ltyridium/Bidir_AC_DC/1.Hardware/主板原理图.pdf

## Reviewed

## Drawed

## VER

## Create Date Part Number

PAGE | OF

## Schematic

## Update Date

## SIZE

## Page

## ltyridium ltyridium

V0.1 | A3

# Three_phase_power_system

2023-03-13
2023-03-08

# Schematic4

## Topology

控制地

5V 控制

# 辅助电源 12V 1A

# 24v 半桥卡

# 5v 控制卡

# CL+继电器 EMI滤波板

电压采样

电流采样

3.3v 驱动缓冲 | 信号调理

# 黄A 绿B 红C 蓝N

# 白 BUS + 黑 BUS -

# 控制地

# BUS+

# MID

# BUS-

# 500V/2.5mm

# 200V/1mm

# 500V/2.5mm

# 安全隔离等级 200v/mm 电气间隙

2.5mm

2.5mm

# 1000v/5mm

信号线0.15mm
电源线0.5mm

# 3V3_AAGND

U12 1

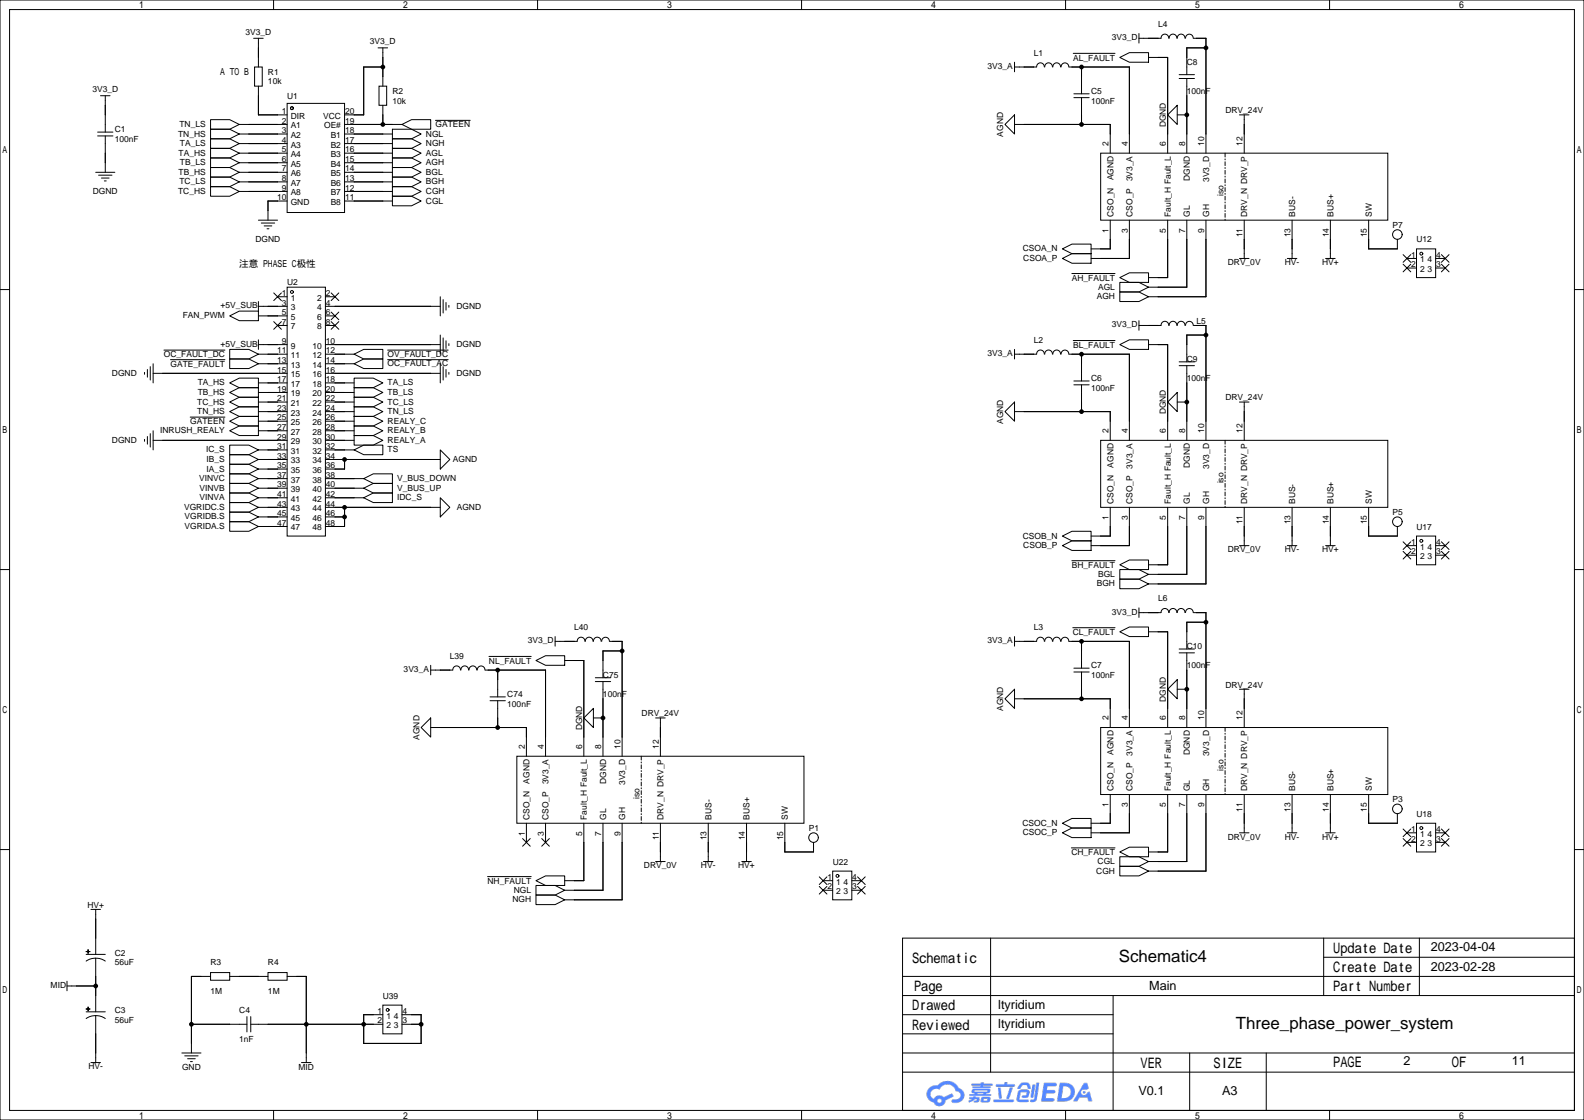
[picture p36: page 2]

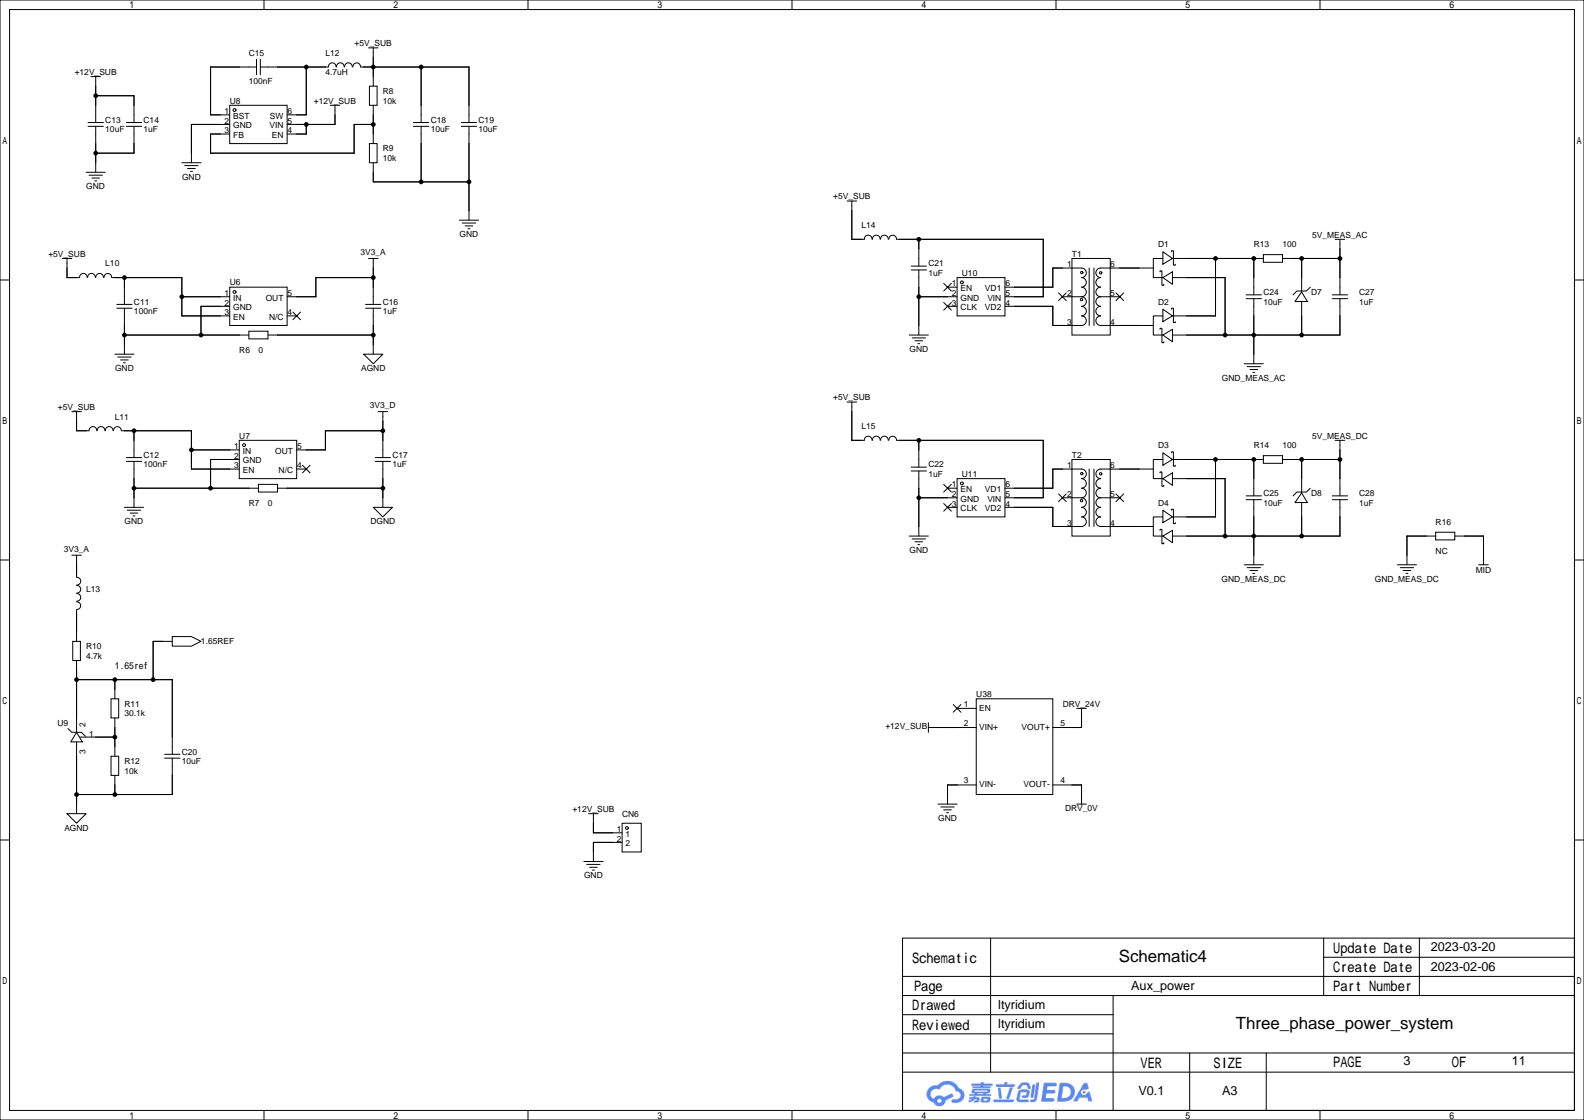
[picture p37: page 3]

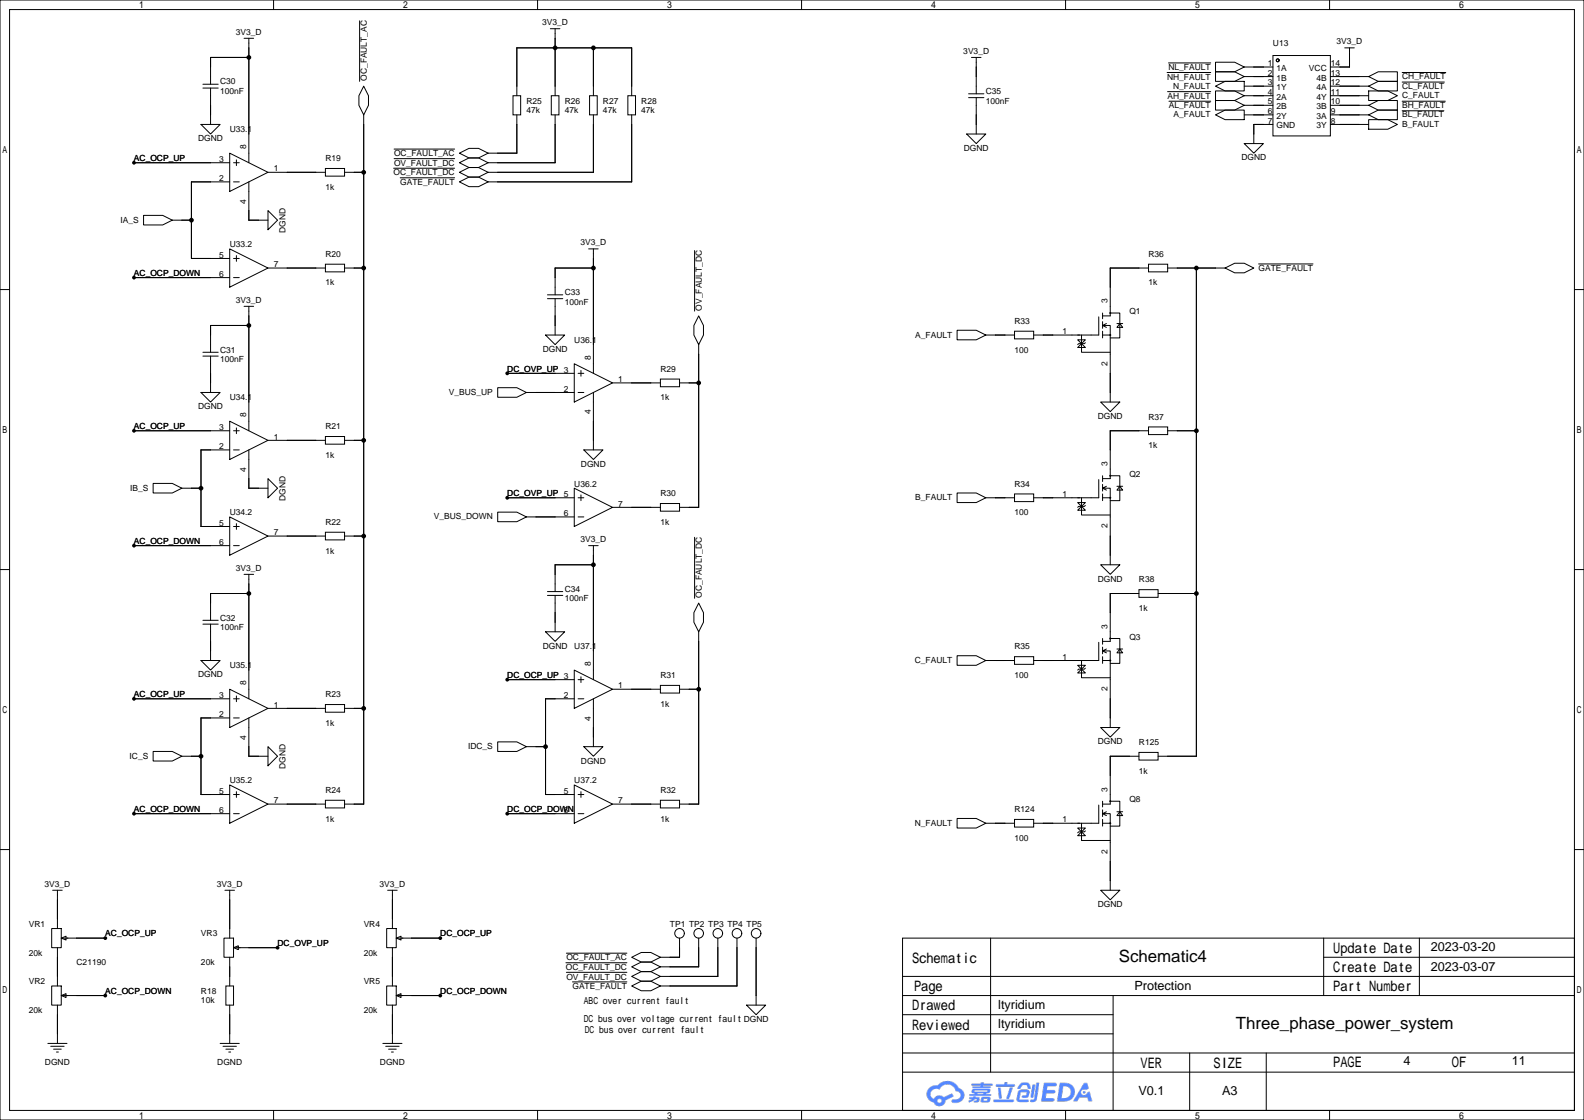
[picture p38: page 4]

DC bus over voltage current fault
DC bus over current fault

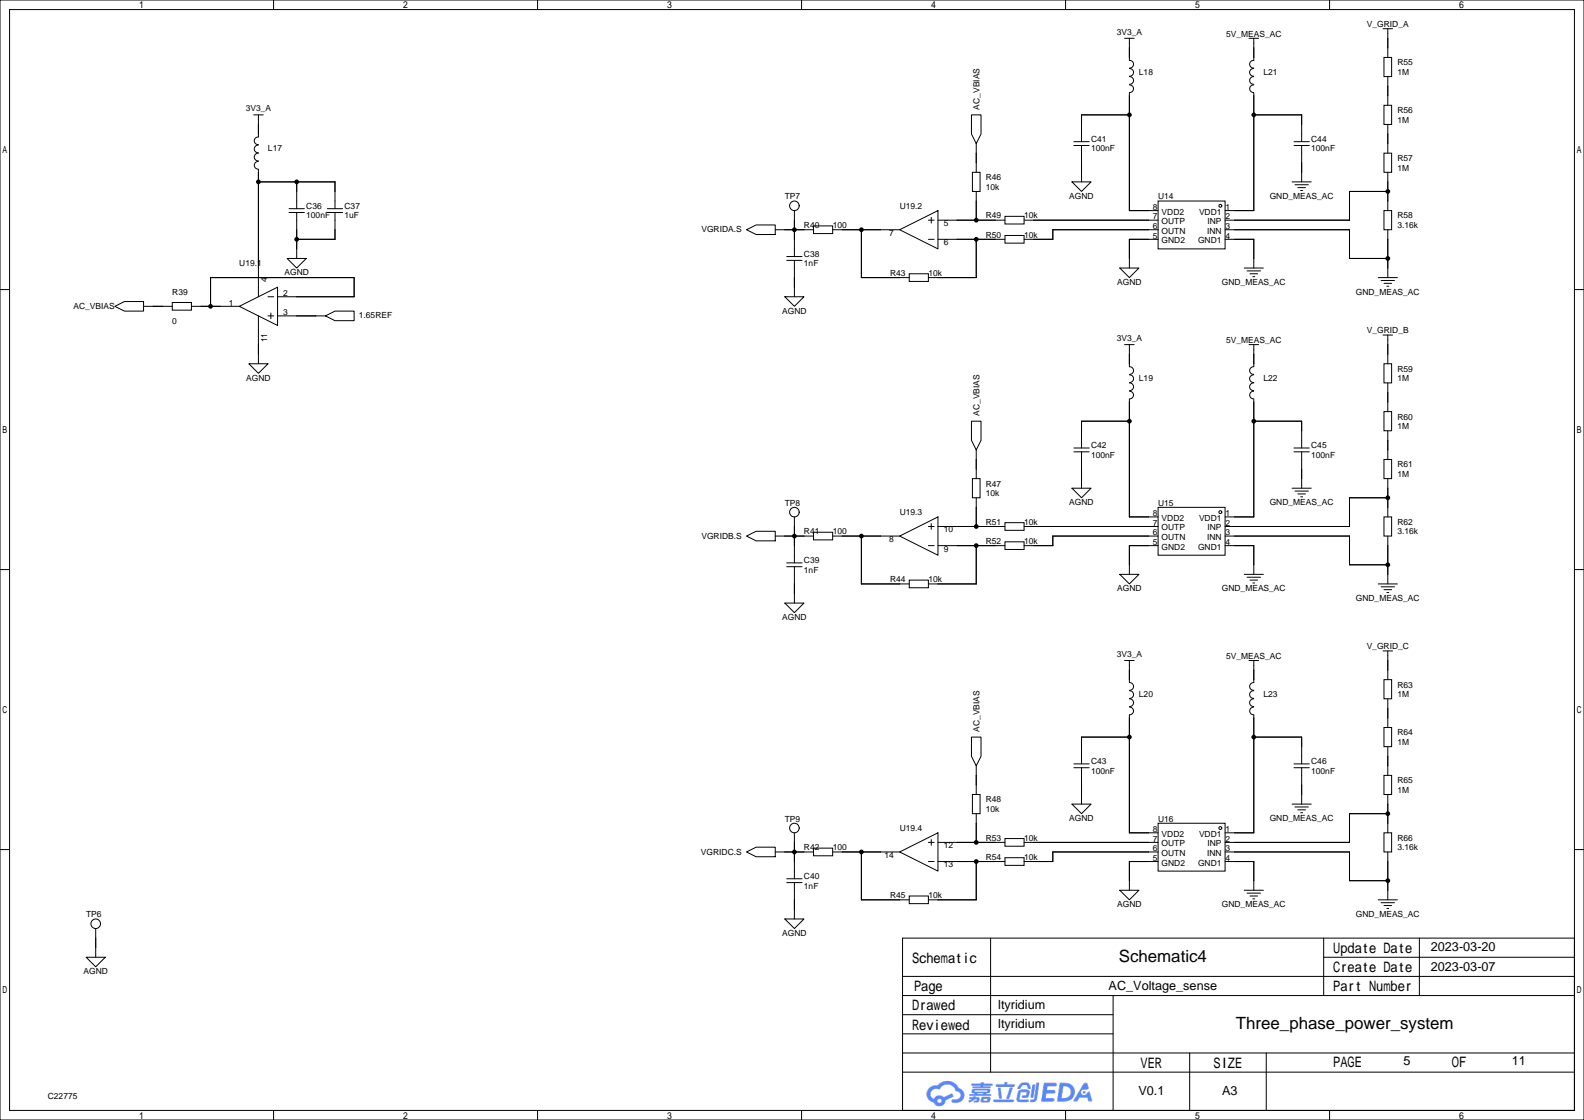
[picture p39: page 5]

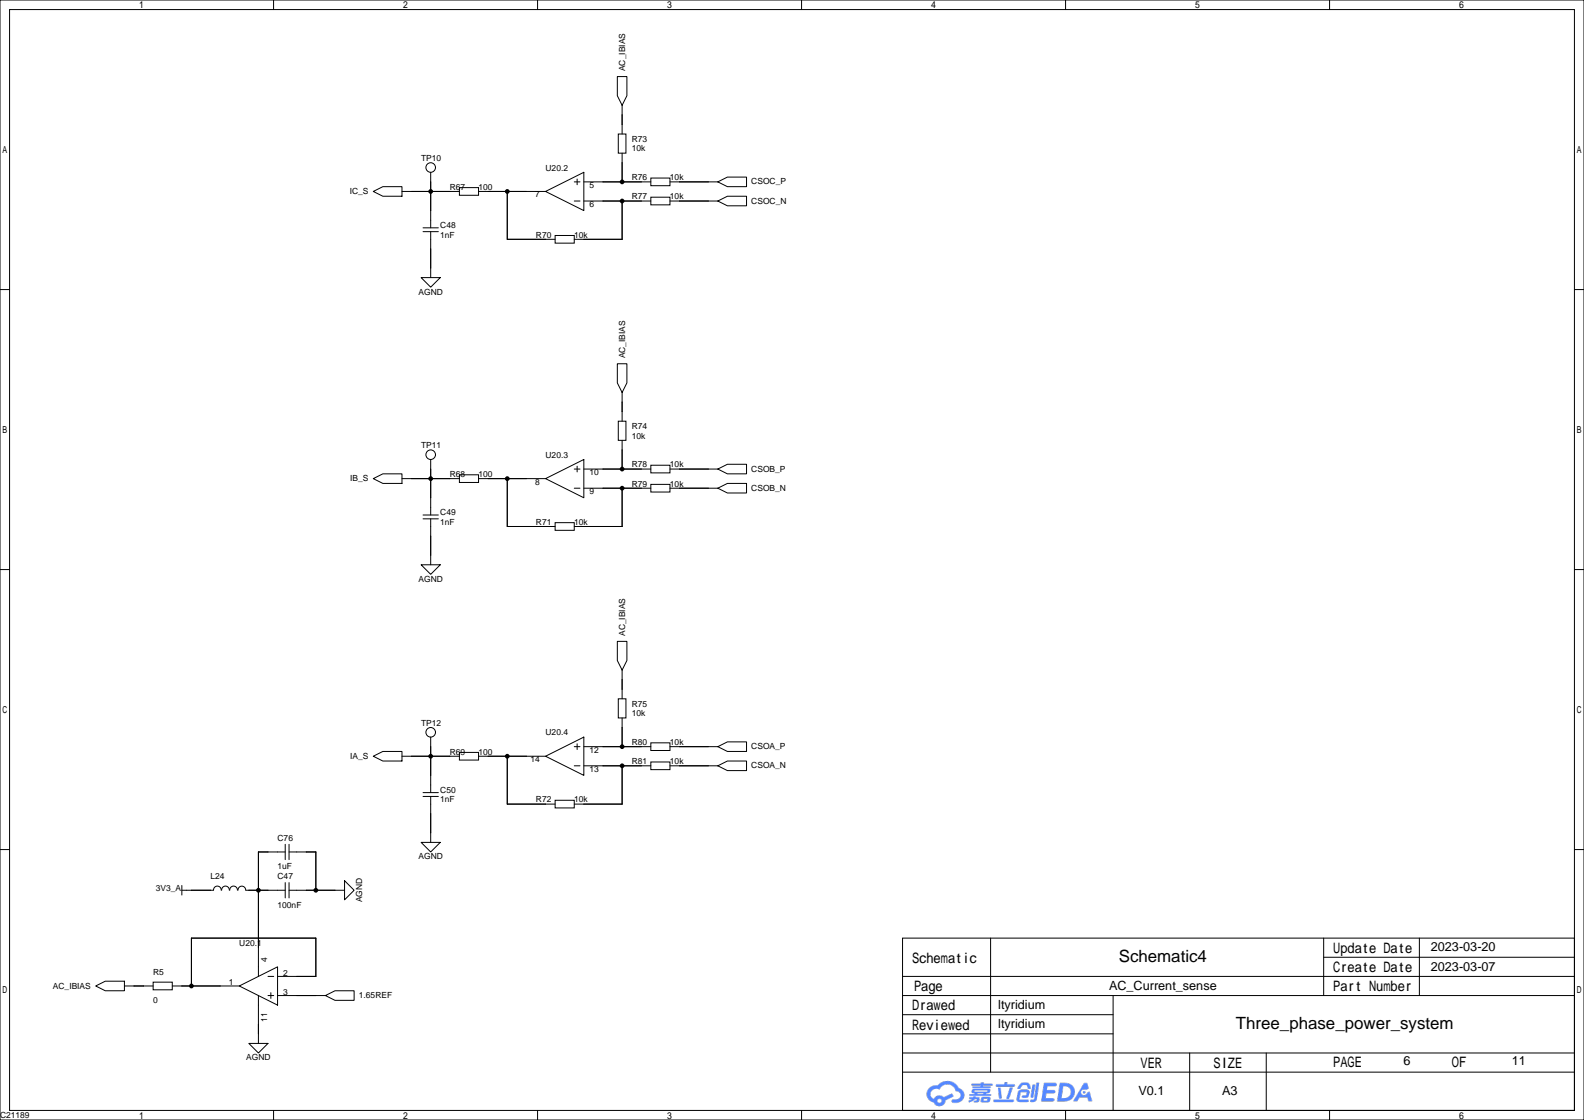
[picture p40: page 6]

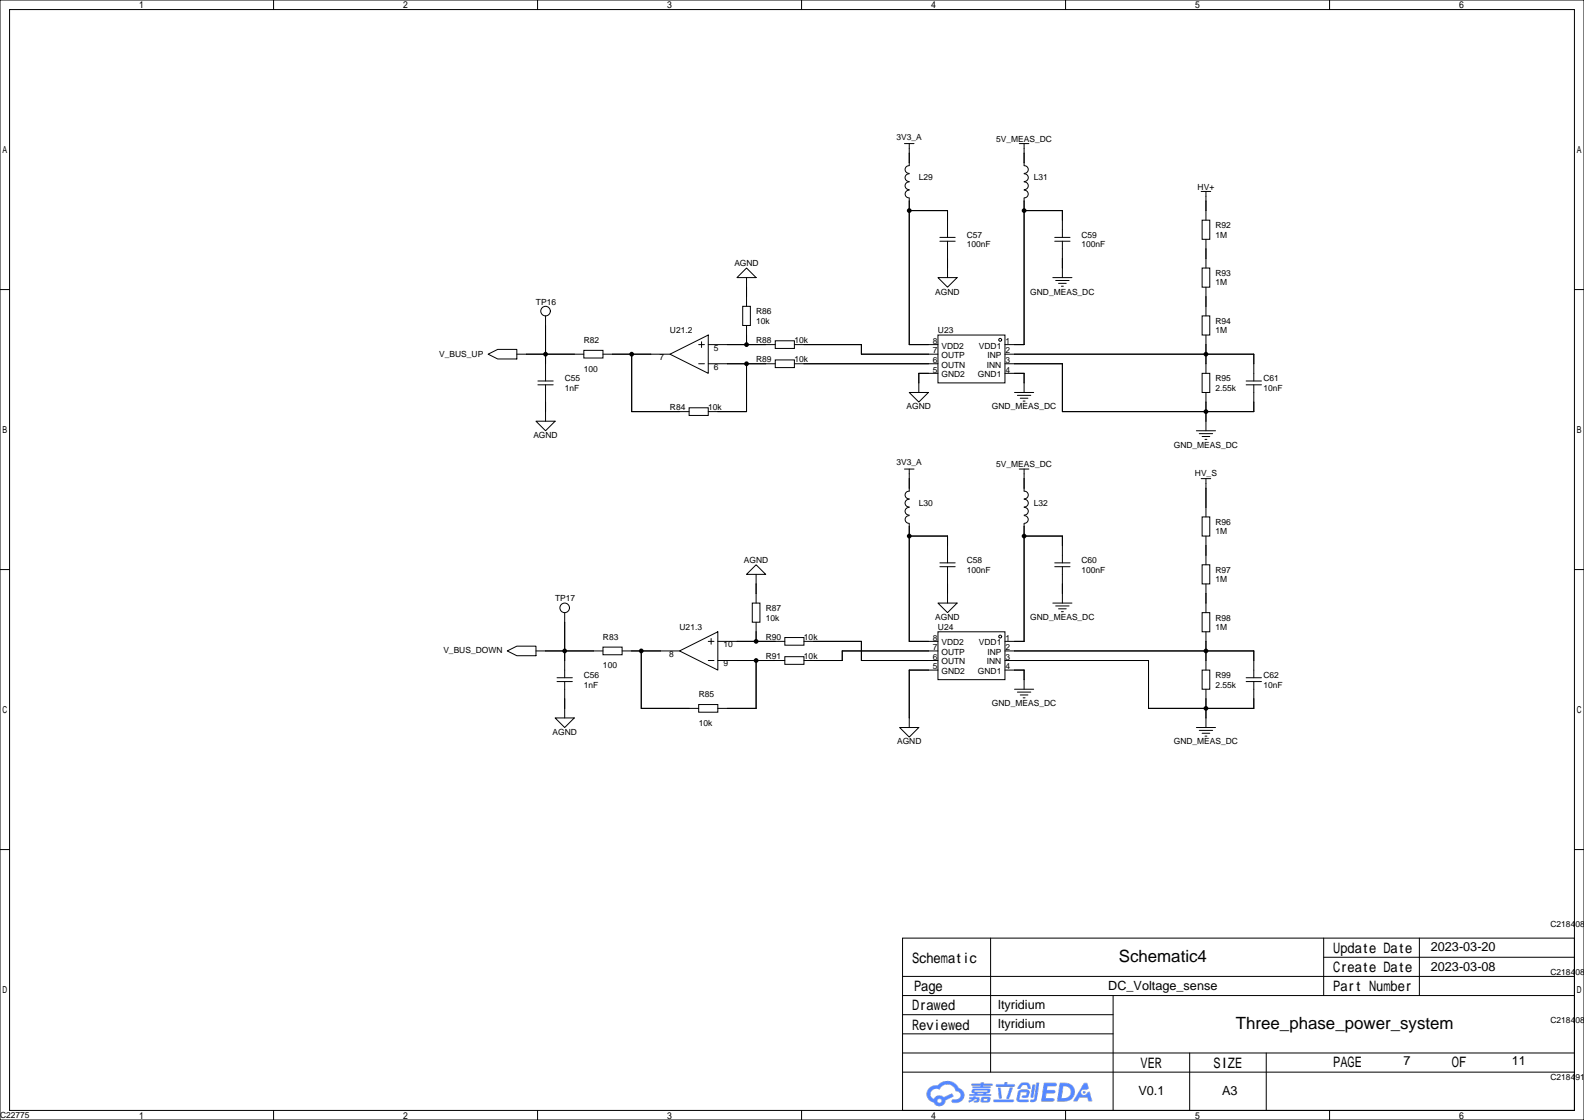
[picture p41: page 7]

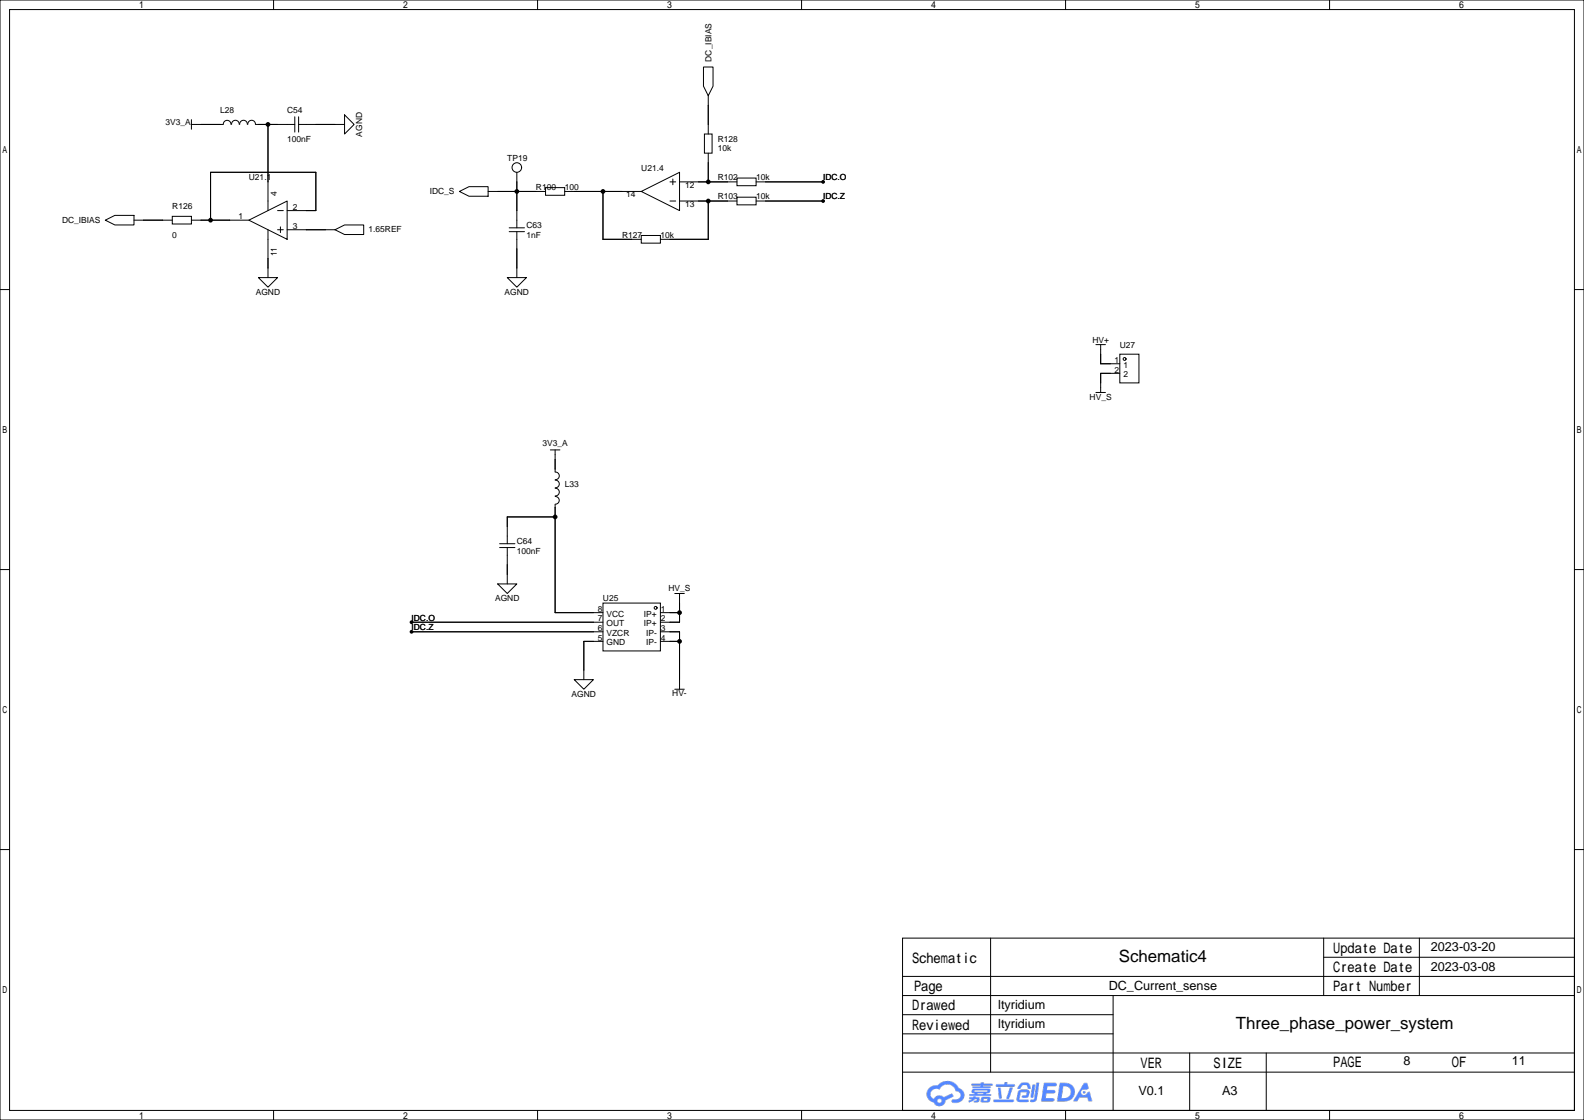
[picture p42: page 8]

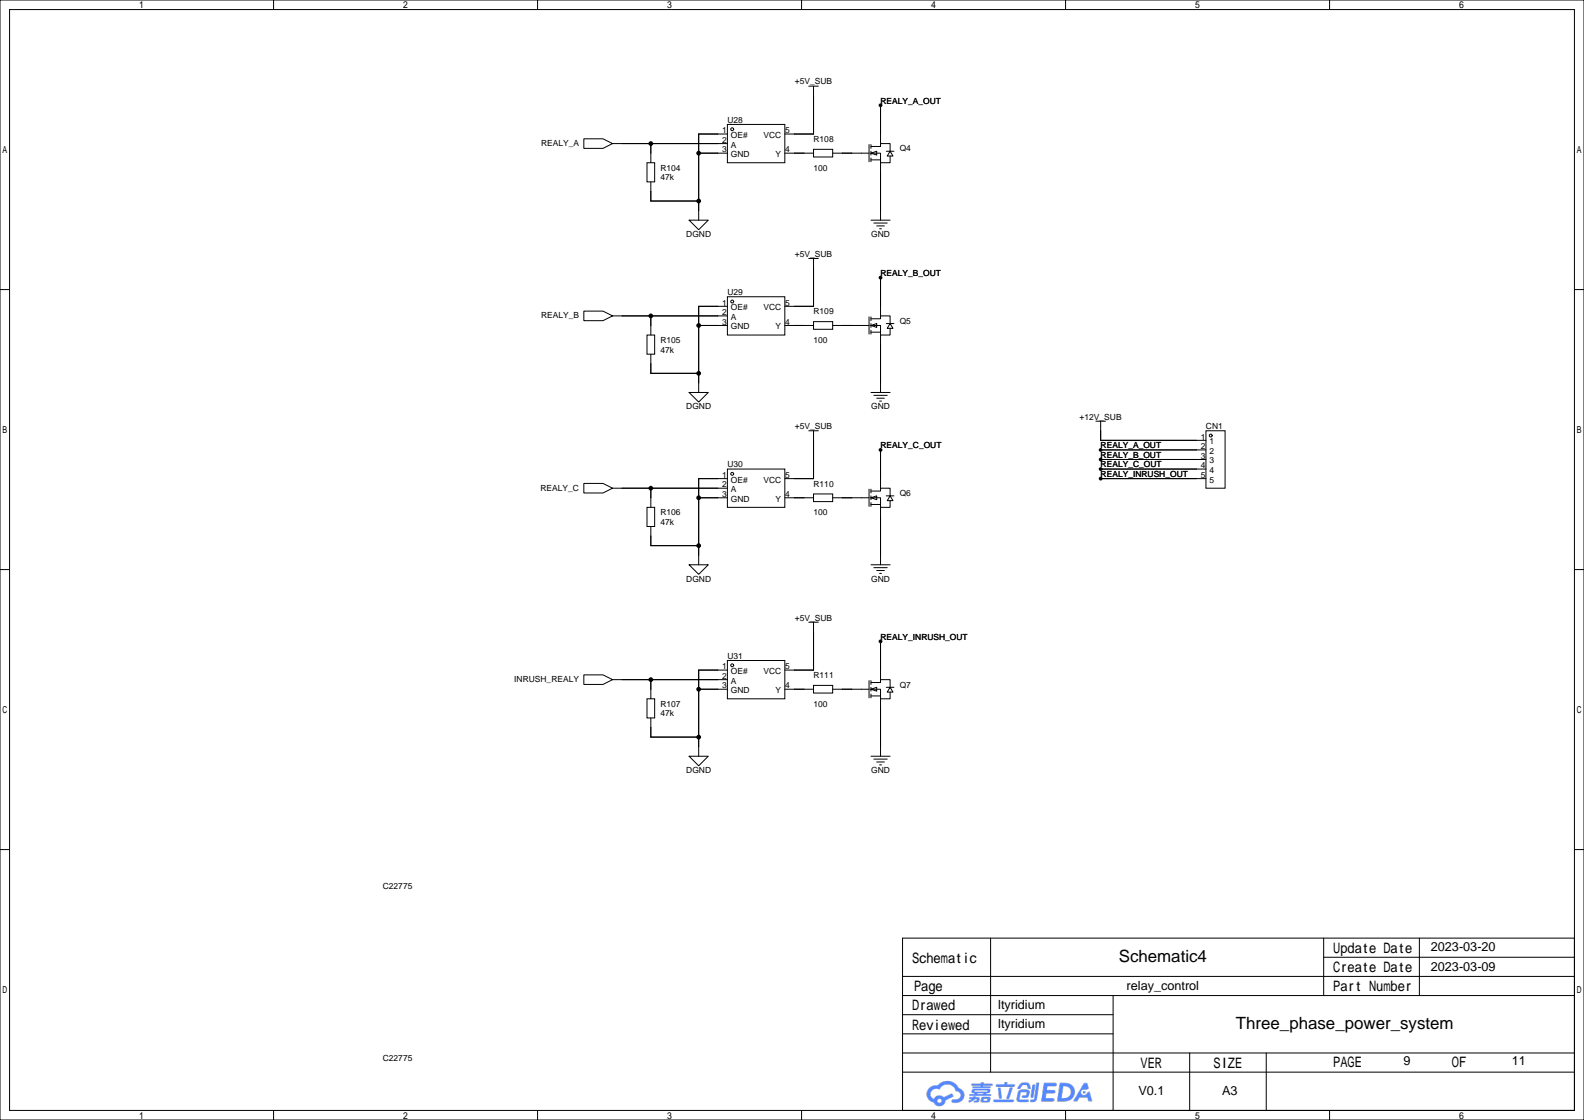
[picture p43: page 9]

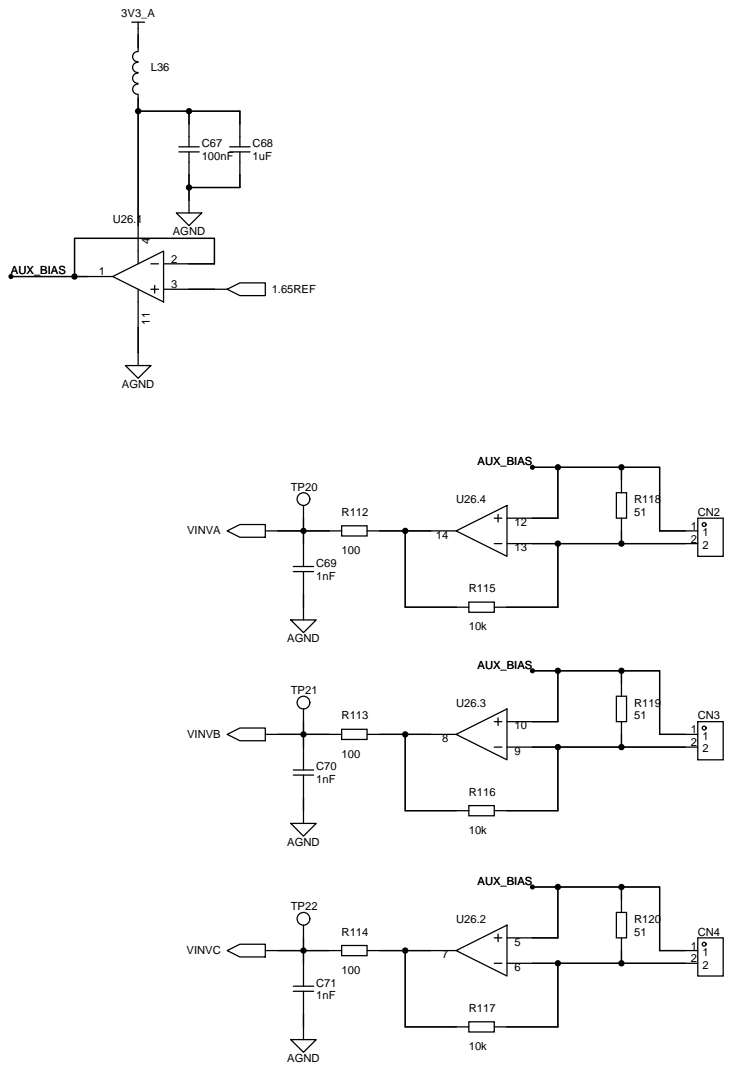
[picture p44: page 10]

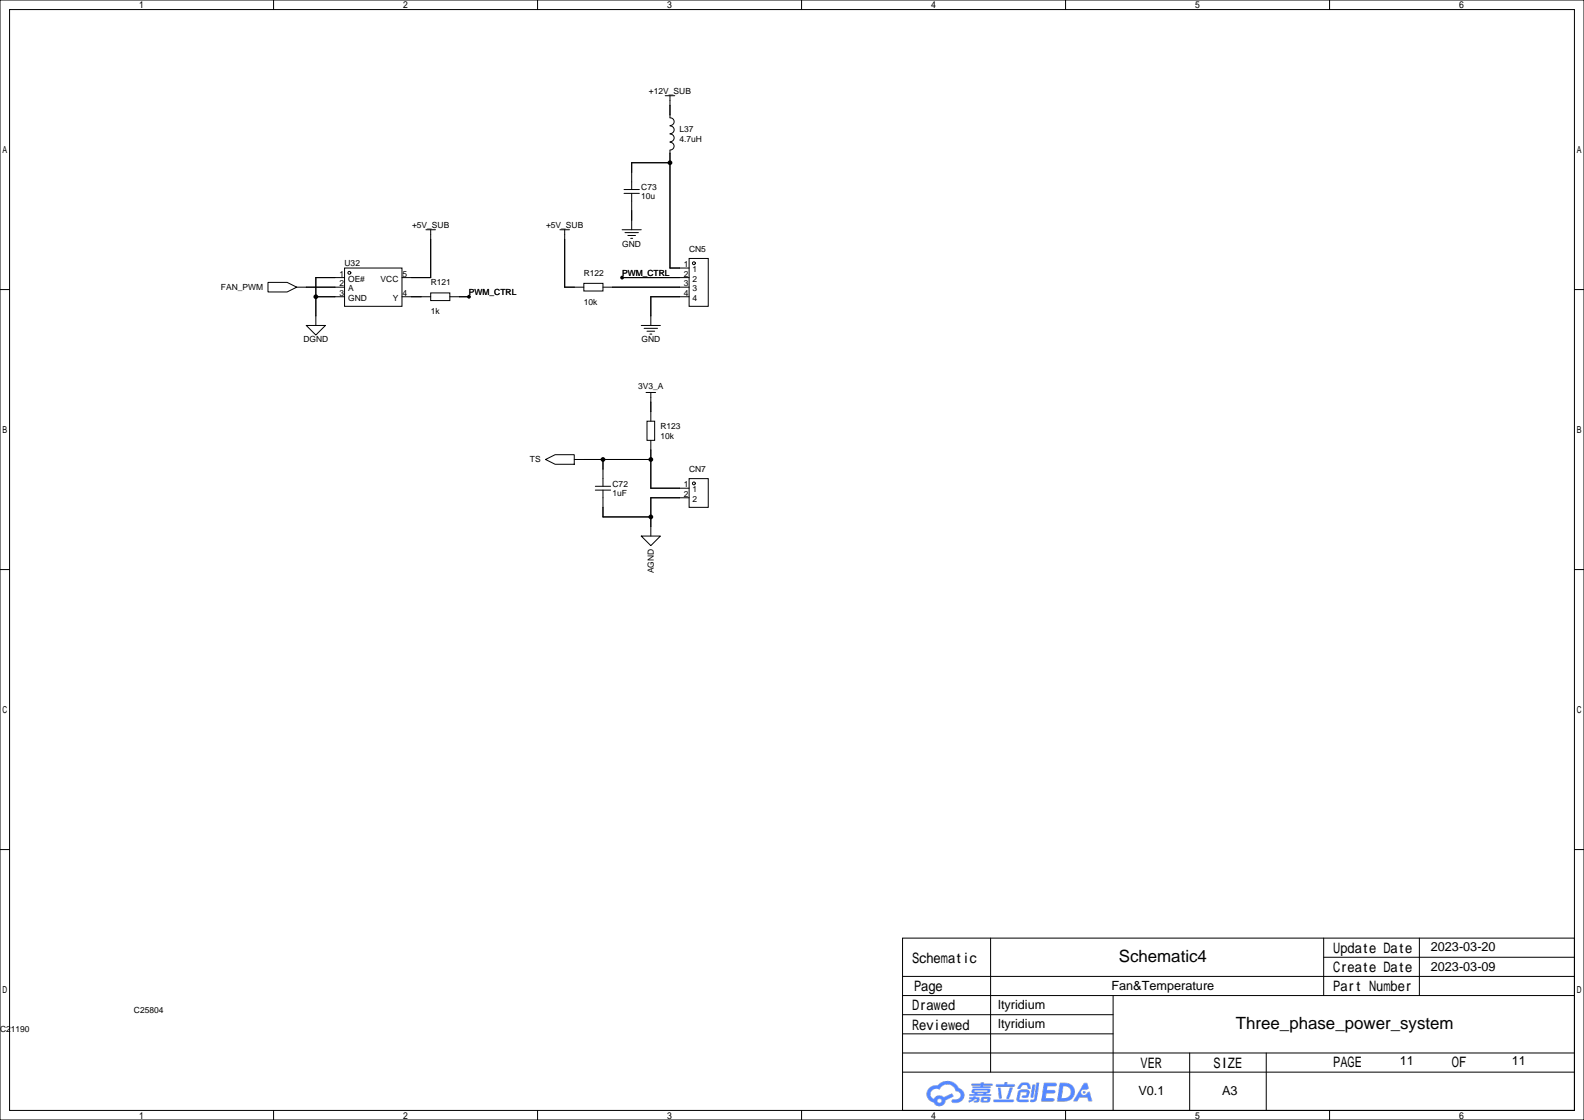
[picture p45: page 11]
