ltyridium/Bidir_AC_DC/1.Hardware/控制卡.pdf

# DGNDI2C¹_SCL I2C¹_SDA

# VDD_3V3 I2C¹_SCL

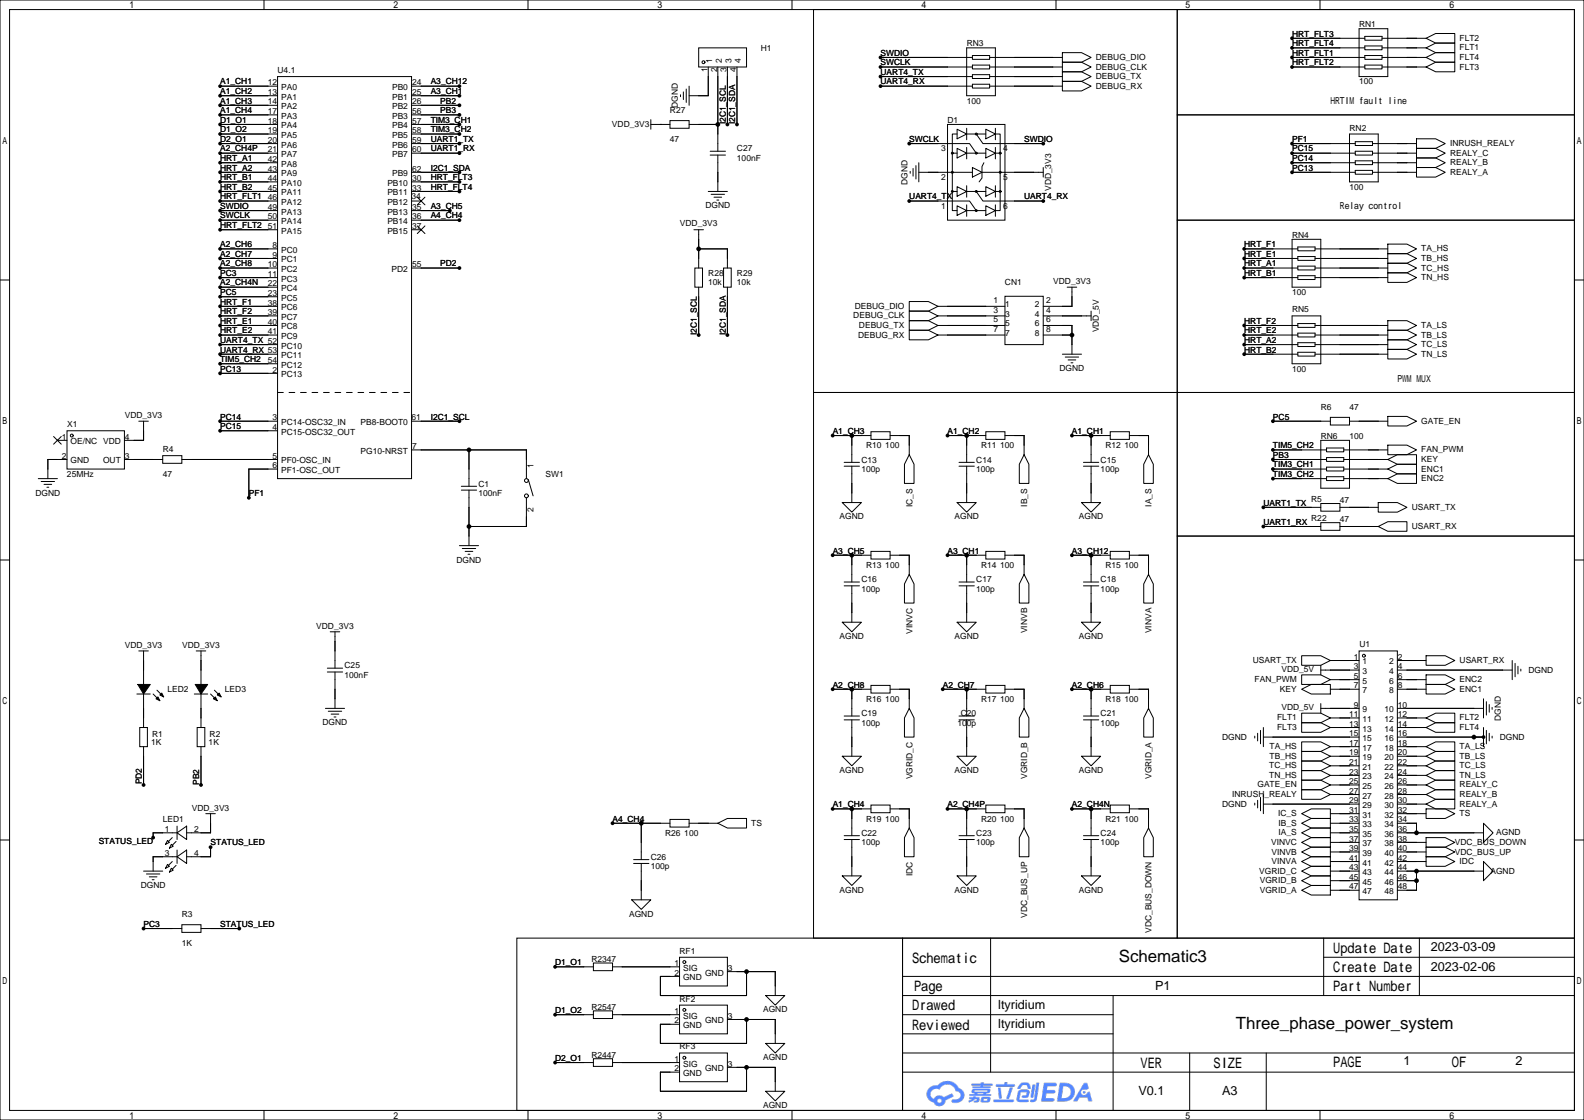
[picture p46: page 1]

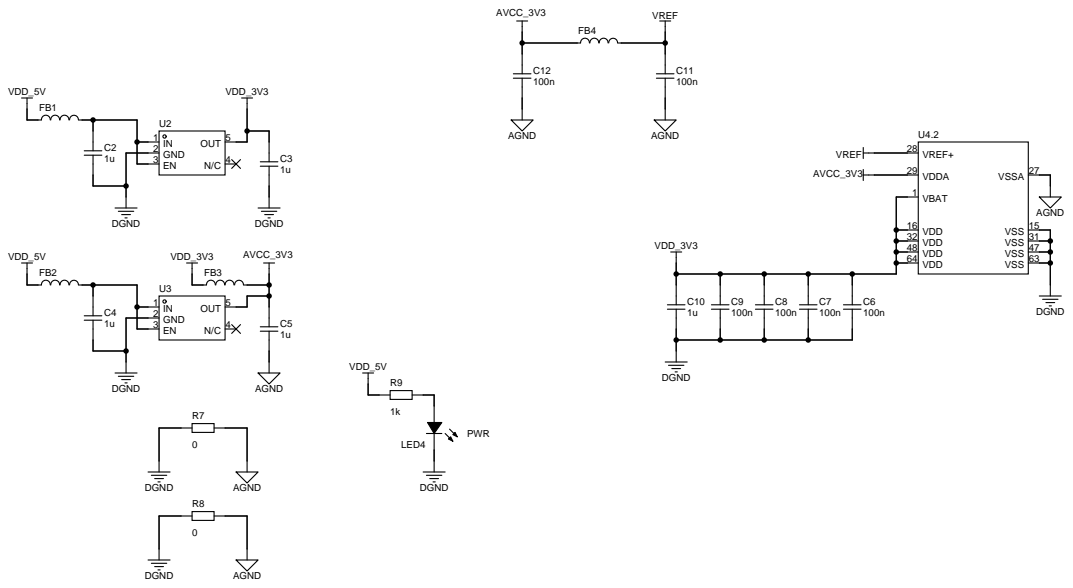
[picture p47: page 2]
