ltyridium/Bidir_AC_DC/1.Hardware/EMI滤波.pdf

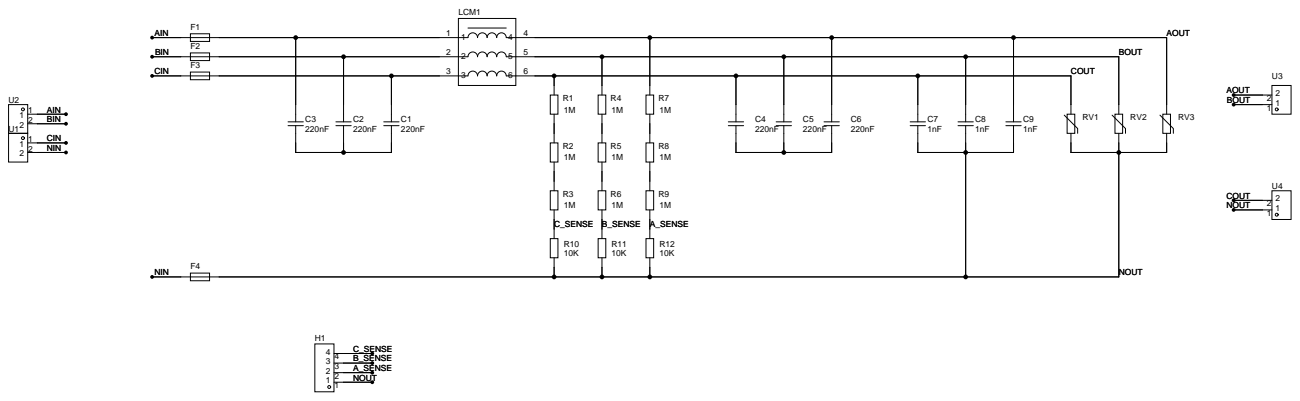
[picture p48: page 1]
