ltyridium/Bidir_AC_DC/1.Hardware/LCL滤波板.pdf

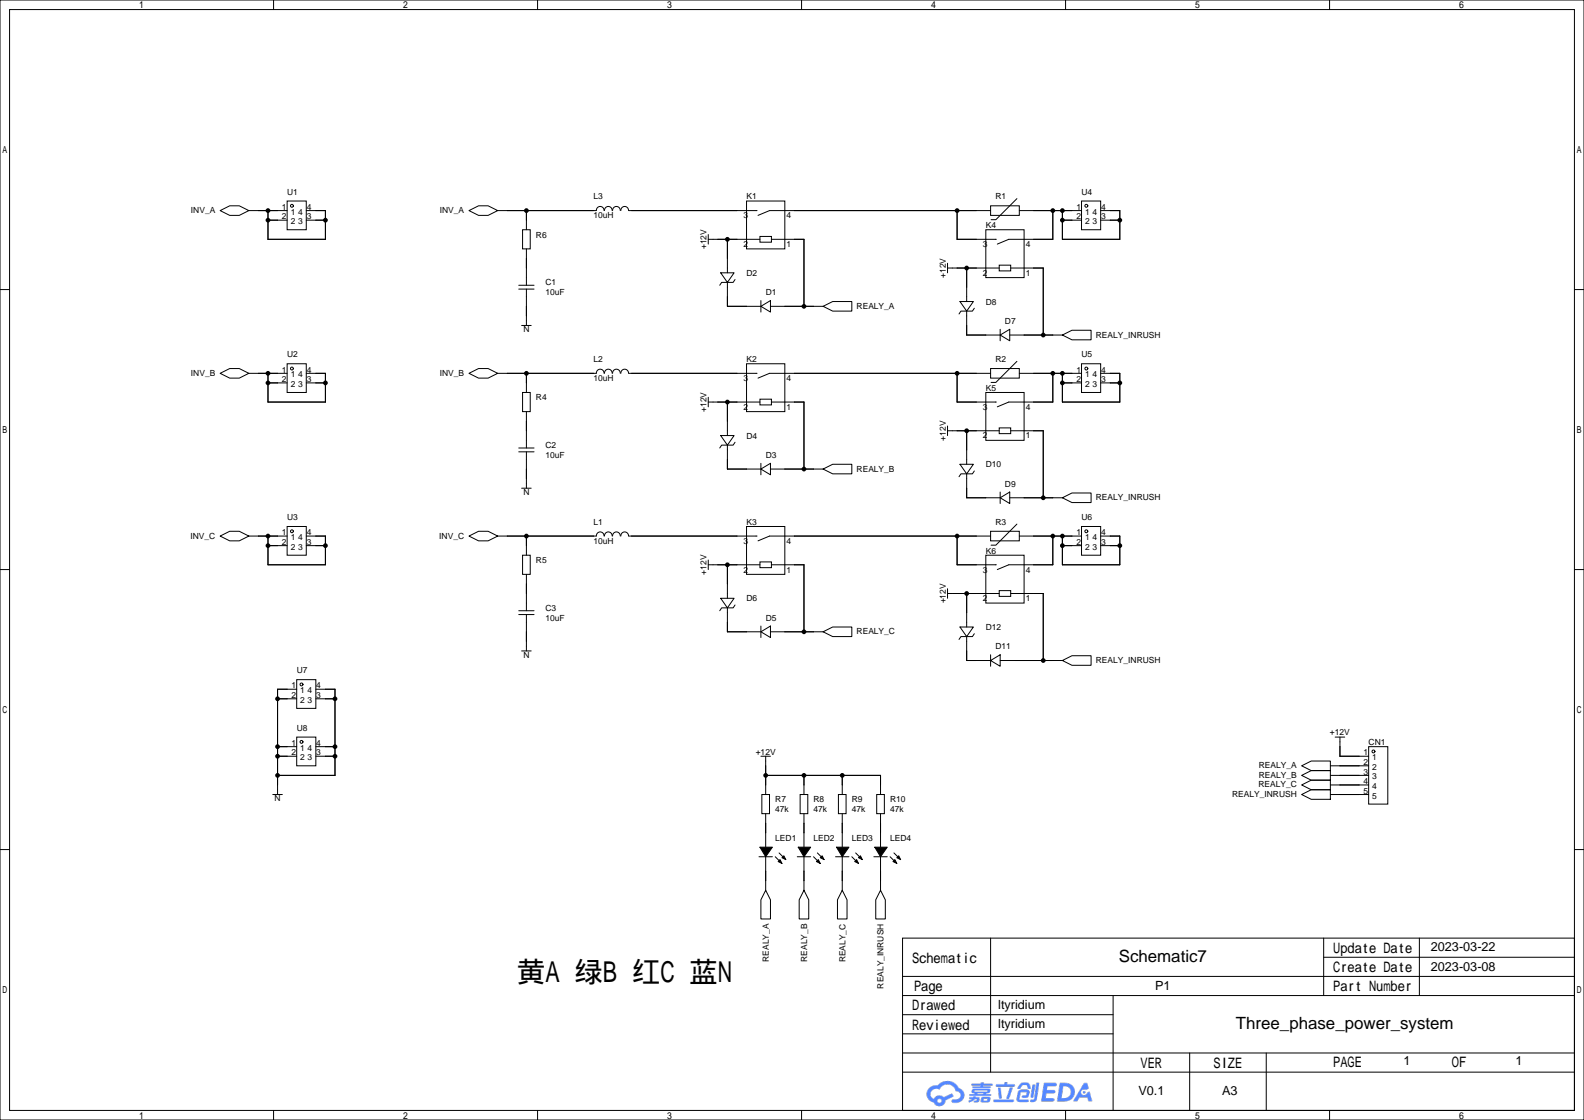
[picture p49: page 1]
