ltyridium/Bidir_AC_DC/1.Hardware/半桥卡.pdf

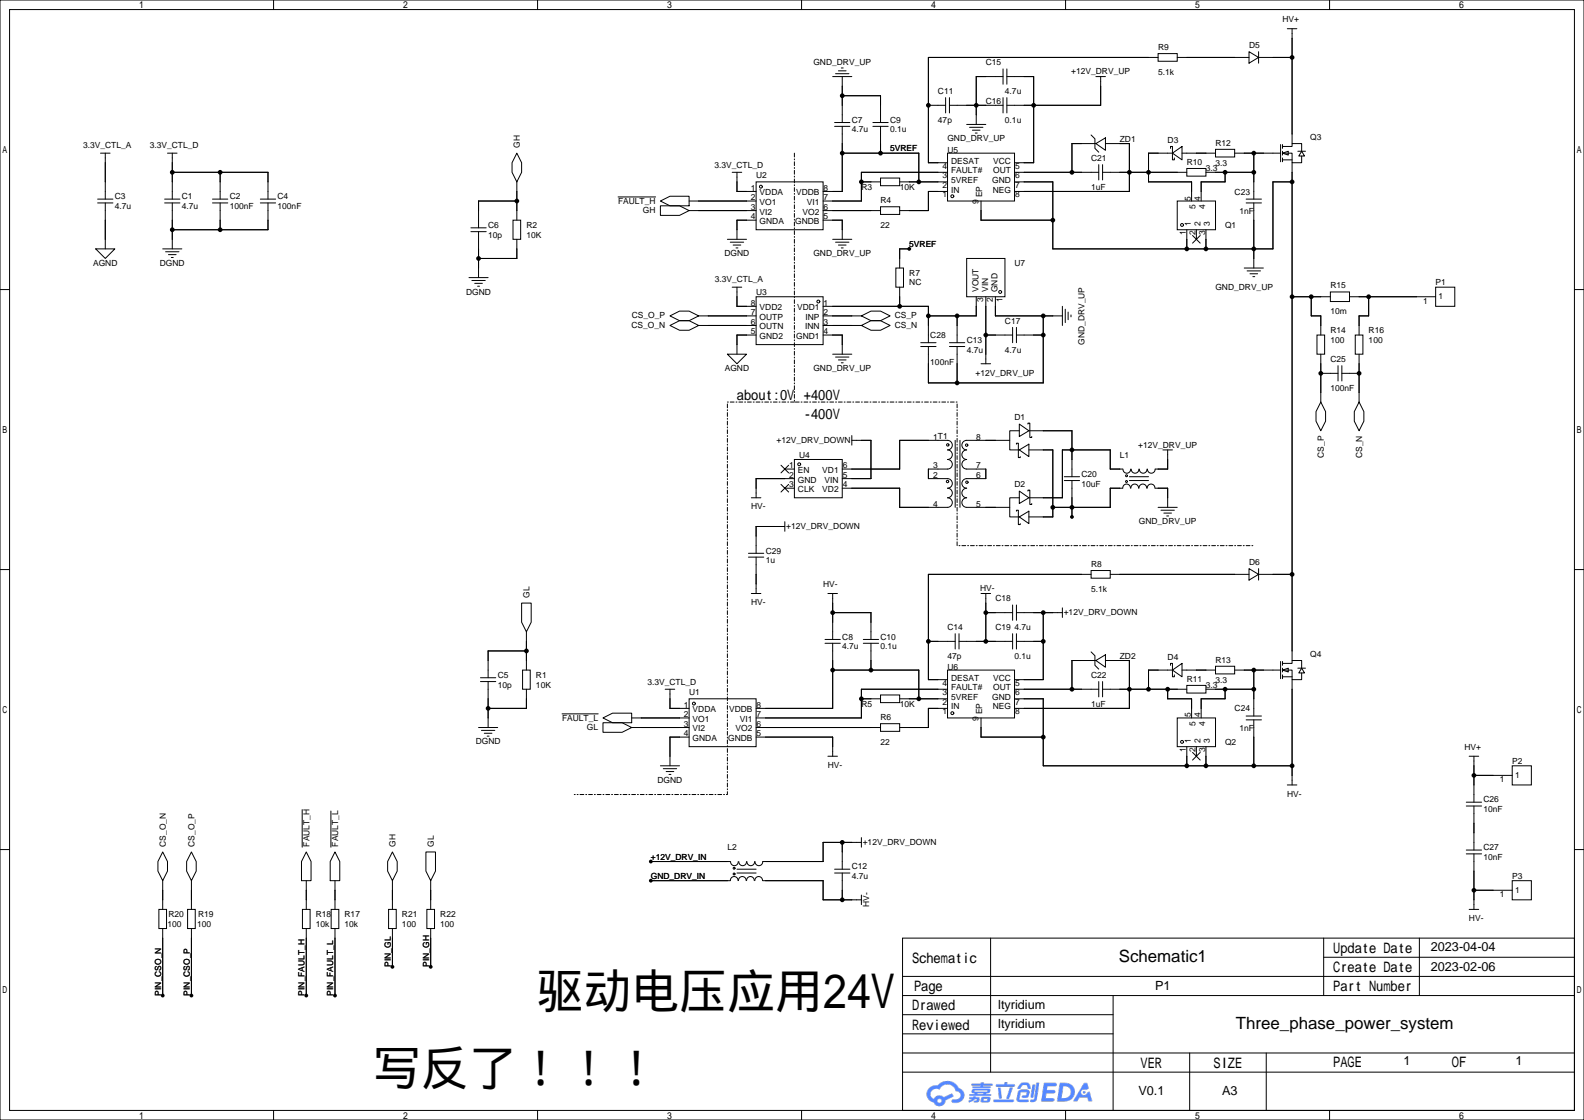
[picture p50: page 1]
