ltyridium/Bidir_AC_DC/2.Firmware/MCU/Core/Inc/main.h

#define FANTIMERARR (6800)
#define RLY_A_Pin LL_GPIO_PIN_13
#define RLY_A_GPIO_Port GPIOC
#define RLY_B_Pin LL_GPIO_PIN_14
#define RLY_B_GPIO_Port GPIOC
#define RLY_C_Pin LL_GPIO_PIN_15
#define RLY_C_GPIO_Port GPIOC
#define INRUSH_RELAY_Pin LL_GPIO_PIN_1
#define INRUSH_RELAY_GPIO_Port GPIOF
#define VgridA_Pin LL_GPIO_PIN_0
#define VgridA_GPIO_Port GPIOC
#define VgridB_Pin LL_GPIO_PIN_1
#define VgridB_GPIO_Port GPIOC
#define VgridC_Pin LL_GPIO_PIN_2
#define VgridC_GPIO_Port GPIOC
#define LED_statue_Pin LL_GPIO_PIN_3
#define LED_statue_GPIO_Port GPIOC
#define IA__Pin LL_GPIO_PIN_0
#define IA__GPIO_Port GPIOA
#define IB__Pin LL_GPIO_PIN_1
#define IB__GPIO_Port GPIOA
#define IC__Pin LL_GPIO_PIN_2
#define IC__GPIO_Port GPIOA
#define Idcbus_Pin LL_GPIO_PIN_3
#define Idcbus_GPIO_Port GPIOA
#define TRACE_Pin LL_GPIO_PIN_6
#define TRACE_GPIO_Port GPIOA
#define Vbus_up_Pin LL_GPIO_PIN_7
#define Vbus_up_GPIO_Port GPIOA
#define Vbus_down_Pin LL_GPIO_PIN_4
#define Vbus_down_GPIO_Port GPIOC
#define EN_GATE_Pin LL_GPIO_PIN_5
#define EN_GATE_GPIO_Port GPIOC
#define ILA_Pin LL_GPIO_PIN_0
#define ILA_GPIO_Port GPIOB
#define ILB_Pin LL_GPIO_PIN_1
#define ILB_GPIO_Port GPIOB
#define LED_B_Pin LL_GPIO_PIN_2
#define LED_B_GPIO_Port GPIOB
#define ILC_Pin LL_GPIO_PIN_13
#define ILC_GPIO_Port GPIOB
#define FAN_PWM_Pin LL_GPIO_PIN_12
#define FAN_PWM_GPIO_Port GPIOC
#define LED_G_Pin LL_GPIO_PIN_2
#define LED_G_GPIO_Port GPIOD
#define NVIC_PRIORITYGROUP_0         ((uint32_t)0x00000007) /*!< 0 bit  for pre-emption priority,
#define NVIC_PRIORITYGROUP_1         ((uint32_t)0x00000006) /*!< 1 bit  for pre-emption priority,
#define NVIC_PRIORITYGROUP_2         ((uint32_t)0x00000005) /*!< 2 bits for pre-emption priority,
#define NVIC_PRIORITYGROUP_3         ((uint32_t)0x00000004) /*!< 3 bits for pre-emption priority,
#define NVIC_PRIORITYGROUP_4         ((uint32_t)0x00000003) /*!< 4 bits for pre-emption priority,
