ltyridium/Bidir_AC_DC/2.Firmware/MCU/Drivers/OLED/oled.h

#ifndef __OLED_H
#define __OLED_H

//#include "device.h"
#include "stdint.h"
/* OLED鎺у埗鐢ㄥ嚱鏁� */
void OLED_Set_Pos(uint8_t x, uint8_t y);
void OLED_Display_On(void);
void OLED_Display_Off(void);
void OLED_Clear(void);
void OLED_On(void);

/* OLED鍔熻兘鍑芥暟 */
void OLED_ShowChar(uint8_t x,uint8_t y,uint8_t chr,uint8_t size);
void OLED_ShowNum(uint8_t x,uint8_t y,uint32_t num,uint8_t len,uint8_t size);
void OLED_ShowString(uint8_t x,uint8_t y, char *chr,uint8_t size);
void OLED_ShowCHinese(uint8_t x,uint8_t y,uint8_t no);
void OLED_DrawBMP(uint8_t x0, uint8_t y0,uint8_t x1, uint8_t y1,uint8_t BMP[]);

/* OLED鍒濆鍖� */
void OLED_Init(void);

#endif
